nus-wira/alex-4-1-2/LiDAR/w7s2.cpp

/*
 *  RPLIDAR
 *  Simple Data Grabber Demo App
 *
 *  Copyright (c) 2009 - 2014 RoboPeak Team
 *  http://www.robopeak.com
 *  Copyright (c) 2014 - 2016 Shanghai Slamtec Co., Ltd.
 *  http://www.slamtec.com
 *
 */
/*
 * This program is free software: you can redistribute it and/or modify
 * it under the terms of the GNU General Public License as published by
 * the Free Software Foundation, either version 3 of the License, or
 * (at your option) any later version.
 *
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
 */

#include <stdio.h>
#include <stdlib.h>
#include <math.h>

#include "Include/rplidar.h" //RPLIDAR standard sdk, all-in-one header


#ifndef _countof
#define _countof(_Array) (int)(sizeof(_Array) / sizeof(_Array[0]))
#endif

#ifdef _WIN32
#include <Windows.h>
#define delay(x)   ::Sleep(x)
#else
#include <unistd.h>

//For CG1112 Starts
const int DEF_MARGIN = 20;
const int DISP_RING_ABS_DIST  = 100;
const float DISP_FULL_DIST    = 16000;
const float DISP_DEFAULT_DIST = 8000;
const float DISP_MIN_DIST     = 1000;
const float PI   = (float)3.14159265;
//For CG1112 Ends

static inline void delay(_word_size_t ms){
    while (ms>=1000){
        usleep(1000*1000);
        ms-=1000;
    };
    if (ms!=0)
        usleep(ms*1000);
}
#endif

using namespace rp::standalone::rplidar;

void print_usage(int argc, const char * argv[])
{
    printf("Simple LIDAR 2D Plot for RPLIDAR.\n"
           "Version: " RPLIDAR_SDK_VERSION "\n"
           "Usage:\n"
           "%s <com port> [baudrate]\n"
           "The default baudrate is 115200. Please refer to the datasheet for details.\n"
           , argv[0]);
}

u_result capture_and_display(RPlidarDriver * drv, const char* fname)
{


    u_result ans;
    
    rplidar_response_measurement_node_t nodes[360*2];
    size_t   count = _countof(nodes);

    float angle;
    float dist;
    _u8   quality;

    FILE* outputFile;

    printf("waiting for data...\n");

    // fetch exactly one 0-360 degrees' scan
    ans = drv->grabScanData(nodes, count);
    if (IS_OK(ans) || ans == RESULT_OPERATION_TIMEOUT) {

        drv->ascendScanData(nodes, count);
        
        outputFile = fopen(fname, "w");

        for (int pos = 0; pos < (int)count ; ++pos) {
            quality = (nodes[pos].sync_quality>>RPLIDAR_RESP_MEASUREMENT_QUALITY_SHIFT);
            angle = (nodes[pos].angle_q6_checkbit >> RPLIDAR_RESP_MEASUREMENT_ANGLE_SHIFT)/64.0f;
            dist = nodes[pos].distance_q2/4.0f;

            //Print Debug info on screen
            printf("Debug [theta: %03.2f Dist: %08.2f]\n", angle, dist);


            //Calculate the scale of pixel vs distance, 
            //     i.e. 1 pixel = ?? meter
            float distScale = 300/DISP_DEFAULT_DIST;  //300 pixel / default_dist
            float distPixel = dist*distScale;

            //Convert angle to radian
            float rad = (float)(angle*PI/180.0);

            //assume a 320 x 320 pixels display, then center point 
            // (location of the RPLidar unit) is at (x=160, y=160) 
            float centerPtX = 160;
            float centerPtY = 160;

        
            //TODO: Figure out the transformation from angle+distnace
            // to (X,Y) coordinate
            float endptX = centerPtX + distPixel*sin(rad); //change this
            float endptY = centerPtY + distPixel*cos(rad); //change this

            //Quality of the data is represented by brightness
            //Note: Not used for our studio
            int brightness = (quality<<1) + 128;
            if (brightness>255) brightness=255;

            //Print the data into a output data file
            fprintf(outputFile, "%d\t%d\t%d\n",(int)endptX,(int)endptY, brightness);

            
        }

        fclose(outputFile);
        printf("** Scan Complete! **\n\n");

    } else {
        printf("error code: %x\n", ans);
    }

    return ans;
}

int main(int argc, const char * argv[]) {
    const char * opt_com_path = NULL;
    _u32         opt_com_baudrate = 115200;
    u_result     op_result;

    if (argc < 2) {
        print_usage(argc, argv);
        return -1;
    }
    opt_com_path = argv[1];
    if (argc>2) opt_com_baudrate = strtoul(argv[2], NULL, 10);

    // create the driver instance
    RPlidarDriver * drv = RPlidarDriver::CreateDriver(RPlidarDriver::DRIVER_TYPE_SERIALPORT);

    if (!drv) {
        fprintf(stderr, "insufficent memory, exit\n");
        exit(-2);
    }

    rplidar_response_device_health_t healthinfo;
    rplidar_response_device_info_t devinfo;
    do {
        // try to connect
        if (IS_FAIL(drv->connect(opt_com_path, opt_com_baudrate))) {
            fprintf(stderr, "Error, cannot bind to the specified serial port %s.\n"
                    , opt_com_path);
            break;
        }

        // retrieving the device info
        ////////////////////////////////////////
        op_result = drv->getDeviceInfo(devinfo);

        if (IS_FAIL(op_result)) {
            if (op_result == RESULT_OPERATION_TIMEOUT) {
                // you can check the detailed failure reason
                fprintf(stderr, "Error, operation time out.\n");
            } else {
                fprintf(stderr, "Error, unexpected error, code: %x\n", op_result);
                // other unexpected result
            }
            break;
        }

        // print out the device serial number, firmware and hardware version number..
        printf("RPLIDAR S/N: ");
        for (int pos = 0; pos < 16 ;++pos) {
            printf("%02X", devinfo.serialnum[pos]);
        }

        printf("\n"
                "Version: " RPLIDAR_SDK_VERSION "\n"
                "Firmware Ver: %d.%02d\n"
                "Hardware Rev: %d\n"
                , devinfo.firmware_version>>8
                , devinfo.firmware_version & 0xFF
                , (int)devinfo.hardware_version);


        // check the device health
        ////////////////////////////////////////
        op_result = drv->getHealth(healthinfo);
        if (IS_OK(op_result)) { // the macro IS_OK is the preperred way to judge whether the operation is succeed.
            printf("RPLidar health status : ");
            switch (healthinfo.status) {
                case RPLIDAR_STATUS_OK:
                    printf("OK.");
                    break;
                case RPLIDAR_STATUS_WARNING:
                    printf("Warning.");
                    break;
                case RPLIDAR_STATUS_ERROR:
                    printf("Error.");
                    break;
            }
            printf(" (errorcode: %d)\n", healthinfo.error_code);

        } else {
            fprintf(stderr, "Error, cannot retrieve the lidar health code: %x\n", op_result);
            break;
        }


        if (healthinfo.status == RPLIDAR_STATUS_ERROR) {
            fprintf(stderr, "Error, rplidar internal error detected. Please reboot the device to retry.\n");
            // enable the following code if you want rplidar to be reboot by software
            // drv->reset();
            break;
        }

        drv->startMotor();

        // take only one 360 deg scan and display the result as a histogram
        ////////////////////////////////////////////////////////////////////////////////
        if (IS_FAIL(drv->startScan( /* true */ ))) // you can force rplidar to perform scan operation regardless whether the motor is rotating
        {
            fprintf(stderr, "Error, cannot start the scan operation.\n");
            break;
        }

        while (1) {
            if (IS_FAIL(capture_and_display(drv, "lidar_reading.dat"))) {
                fprintf(stderr, "Error, cannot grab scan data.\n");
                break;

            }
        }

    } while(0);

    drv->stop();
    drv->stopMotor();

    RPlidarDriver::DisposeDriver(drv);
    return 0;
}
