nus-wira/alex-4-1-2/(commit log)

2020-03-20 Add Alex movement self-calibration
2020-03-22 I have changed analogWrite() to use PWM
2020-03-22 Add power saving
2020-03-25 Initial w11s1 power management
2020-03-29 Change UCSR0B to turn off interrupts
